n1ghtBl00d/dumbpad/hotswap_rgb_oled/dumbpad.kicad_pcb

## KiCad design hotswap_rgb_oled/dumbpad.kicad_pcb (2022-11-12)

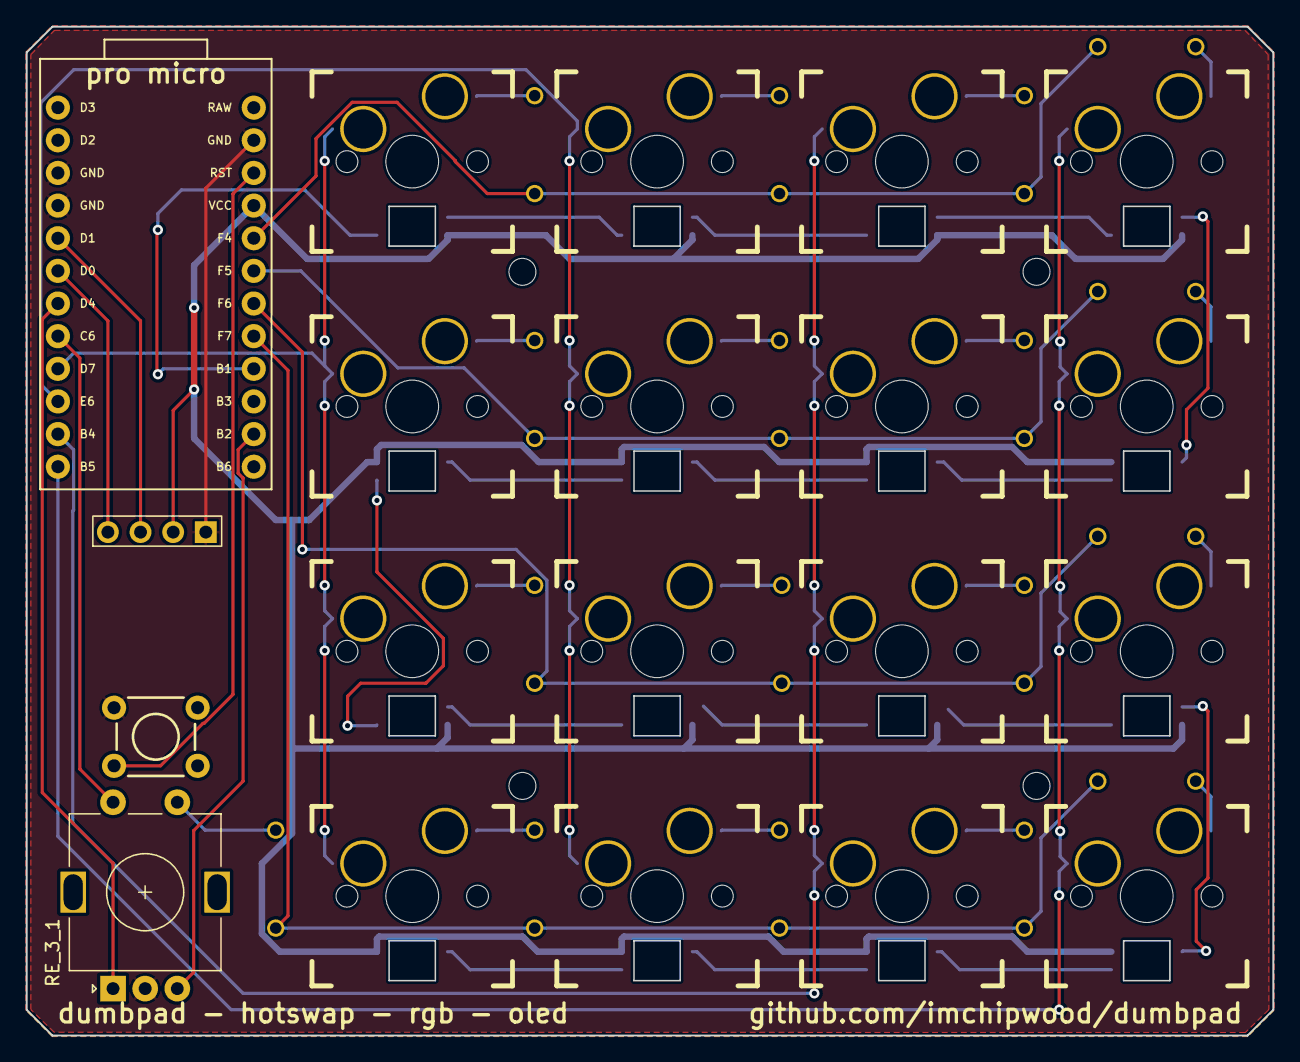
[picture p6: board dumbpad.kicad_pcb from above]

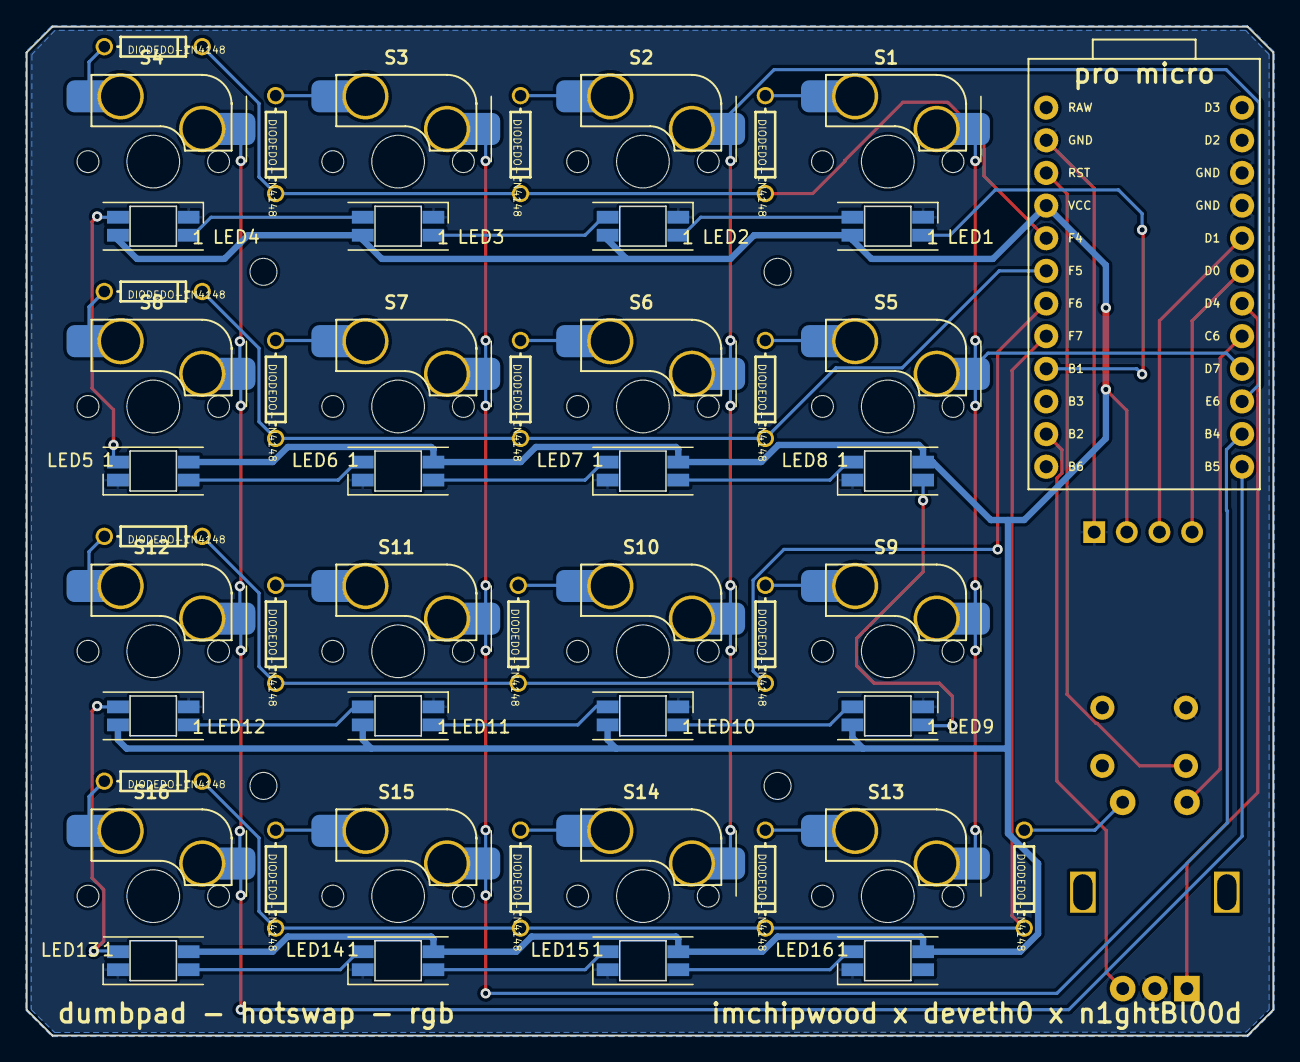
[picture p7: board dumbpad.kicad_pcb from below]

Board: 2 copper layers, 97.0 x 78.5 mm, 53 parts (49 on the bottom side), 49 nets.

Parts:
B1: SPARKFUN_PRO_MICRO
D1, D2, D3, D4, D5, D6, D7, D8, D9, D10, D11, D12, D13, D14, D15, D16, D20: DIODEDO-1N4148; DO-1N4148
J1: Conn_01x04_Female; OLED
LED1, LED2, LED3, LED4, LED5, LED6, LED7, LED8, LED9, LED10, LED11, LED12, LED13, LED14, LED15, LED16: SK6812MINI; YS-SK6812MINI-E
RE_3_1: CHERRY-MX-ENCODER; RotaryEncoder_Alps_EC11E-Switch_Vertical_H20mm
S1, S2, S3, S4, S5, S6, S7, S8, S9, S10, S11, S12, S13, S14, S15, S16: MOMENTARY-SWITCH-SPST-LED-PTH-CHERRY; Kailh-CPG151101S11_MX_Socket-1.00u
S17: MOMENTARY-SWITCH-SPST-PTH-6.0MM; TACTILE_SWITCH_PTH_6.0MM

Connections:
/COL0: B1.8 (*5), RE_3_1.S2 (2)
/COL1: B1.9 (*6), S1.S2 (2), S5.S2 (2), S9.S2 (2), S13.S2 (2)
/COL2: B1.10 (7), S2.S2 (2), S6.S2 (2), S10.S2 (2), S14.S2 (2)
/COL3: B1.11 (8), S3.S2 (2), S7.S2 (2), S11.S2 (2), S15.S2 (2)
/COL4: B1.12 (*9), S4.S2 (2), S8.S2 (2), S12.S2 (2), S16.S2 (2)
/ENCODER0_L0: B1.14 (11(MOSI)), RE_3_1.B
/ENCODER0_L1: B1.7 (4), RE_3_1.A
/KEY_LEDS: B1.16 (13(SCK)), LED1.4 (DIN)
/RESET: B1.22 (RESET), S17.3 (2)
/ROW0: B1.20 (A3), D1.C, D2.C, D3.C, D4.C
/ROW1: B1.19 (A2), D5.C, D6.C, D7.C, D8.C
/ROW2: B1.18 (A1), D9.C, D10.C, D11.C, D12.C
/ROW3: B1.17 (A0), D13.C, D14.C, D15.C, D16.C, D20.C
/SCL: B1.5 (2), J1.3
/SDA: B1.6 (*3), J1.4
GND: B1.3 (GND@1), B1.4 (GND), B1.23 (GND@2), J1.1, LED1.3 (VSS), LED2.3 (VSS), LED3.3 (VSS), LED4.3 (VSS), LED5.3 (VSS), LED6.3 (VSS), LED7.3 (VSS), LED8.3 (VSS), LED9.3 (VSS), LED10.3 (VSS), LED11.3 (VSS), LED12.3 (VSS), LED13.3 (VSS), LED14.3 (VSS), LED15.3 (VSS), LED16.3 (VSS), RE_3_1.C, S17.1
unnamed: D1.A, S1.S1 (1)
unnamed: D2.A, S2.S1 (1)
unnamed: D3.A, S3.S1 (1)
unnamed: D4.A, S4.S1 (1)
unnamed: D5.A, S5.S1 (1)
unnamed: D6.A, S6.S1 (1)
unnamed: D7.A, S7.S1 (1)
unnamed: D8.A, S8.S1 (1)
unnamed: D9.A, S9.S1 (1)
unnamed: D10.A, S10.S1 (1)
unnamed: D11.A, S11.S1 (1)
unnamed: D12.A, S12.S1 (1)
unnamed: D13.A, S13.S1 (1)
unnamed: D14.A, S14.S1 (1)
unnamed: D15.A, S15.S1 (1)
unnamed: D16.A, S16.S1 (1)
unnamed: D20.A, RE_3_1.S1 (1)
unnamed: LED1.2 (DOUT), LED2.4 (DIN)
unnamed: LED2.2 (DOUT), LED3.4 (DIN)
unnamed: LED3.2 (DOUT), LED4.4 (DIN)
unnamed: LED4.2 (DOUT), LED5.4 (DIN)
unnamed: LED5.2 (DOUT), LED6.4 (DIN)
unnamed: LED6.2 (DOUT), LED7.4 (DIN)
unnamed: LED7.2 (DOUT), LED8.4 (DIN)
unnamed: LED8.2 (DOUT), LED9.4 (DIN)
unnamed: LED10.2 (DOUT), LED11.4 (DIN)
unnamed: LED9.2 (DOUT), LED10.4 (DIN)
unnamed: LED11.2 (DOUT), LED12.4 (DIN)
unnamed: LED12.2 (DOUT), LED13.4 (DIN)
unnamed: LED13.2 (DOUT), LED14.4 (DIN)
unnamed: LED14.2 (DOUT), LED15.4 (DIN)
unnamed: LED15.2 (DOUT), LED16.4 (DIN)
VCC: B1.21 (VCC), J1.2, LED1.1 (VDD), LED2.1 (VDD), LED3.1 (VDD), LED4.1 (VDD), LED5.1 (VDD), LED6.1 (VDD), LED7.1 (VDD), LED8.1 (VDD), LED9.1 (VDD), LED10.1 (VDD), LED11.1 (VDD), LED12.1 (VDD), LED13.1 (VDD), LED14.1 (VDD), LED15.1 (VDD), LED16.1 (VDD)
