n1ghtBl00d/dumbpad/(commit log)

2022-11-12 Added Hotswap/OLED variant
    [dumbpad-B_Cu.gbl, dumbpad-B_Mask.gbs, dumbpad-B_Paste.gbp, dumbpad-B_Silkscreen.gbo, dumbpad-Edge_Cuts.gm1, dumbpad-F_Cu.gtl, dumbpad-F_Mask.gts, dumbpad-F_Paste.gtp]
2022-11-12 Updated silkscreen text
    [dumbpad-B_Cu.gbl, dumbpad-B_Mask.gbs, dumbpad-B_Paste.gbp, dumbpad-B_Silkscreen.gbo, dumbpad-Edge_Cuts.gm1, dumbpad-F_Cu.gtl, dumbpad-F_Mask.gts, dumbpad-F_Paste.gtp]
2022-11-12 Updated back silkscreen text
    [dumbpad-B_Cu.gbl, dumbpad-B_Mask.gbs, dumbpad-B_Paste.gbp, dumbpad-B_Silkscreen.gbo, dumbpad-Edge_Cuts.gm1, dumbpad-F_Cu.gtl, dumbpad-F_Mask.gts, dumbpad-F_Paste.gtp]
2022-11-12 Renamed gerber output folder and updated zip file
    [dumbpad-B_Cu.gbl, dumbpad-B_Mask.gbs, dumbpad-B_Paste.gbp, dumbpad-B_Silkscreen.gbo, dumbpad-Edge_Cuts.gm1, dumbpad-F_Cu.gtl, dumbpad-F_Mask.gts, dumbpad-F_Paste.gtp]
